thelateperseus/OffroadBalancingRobot/README.md

Offroad Balancing Robot Project
===============================

An Arduino-based, two-wheeled balancing robot which can (hopefully) go offroad.

Components:
* Arduino Nano 33 IoT
* 2x Pololu VNH5019  motor driver
* 2x Pololu 30:1 Metal Gearmotor 37Dx68L mm 12V with 64 CPR Encoder
* 2x Dago Wild Thumper Wheels
* MPU-6050 6 DoF sensor (testing only)

Control Algorithm
-----------------

TODO
