thelateperseus/OffroadBalancingRobot/ball-tracking-tensorflow/requirements_pypi.txt

argparse
imutils==0.5.4
numpy~=1.21.0
opencv-python~=4.5.3.56
picamera==1.13
pyserial==3.5
simple_pid~=1.0.1
smbus~=1.1
