thelateperseus/OffroadBalancingRobot/SpeedFilterTest/FirstOrder4Hz.png

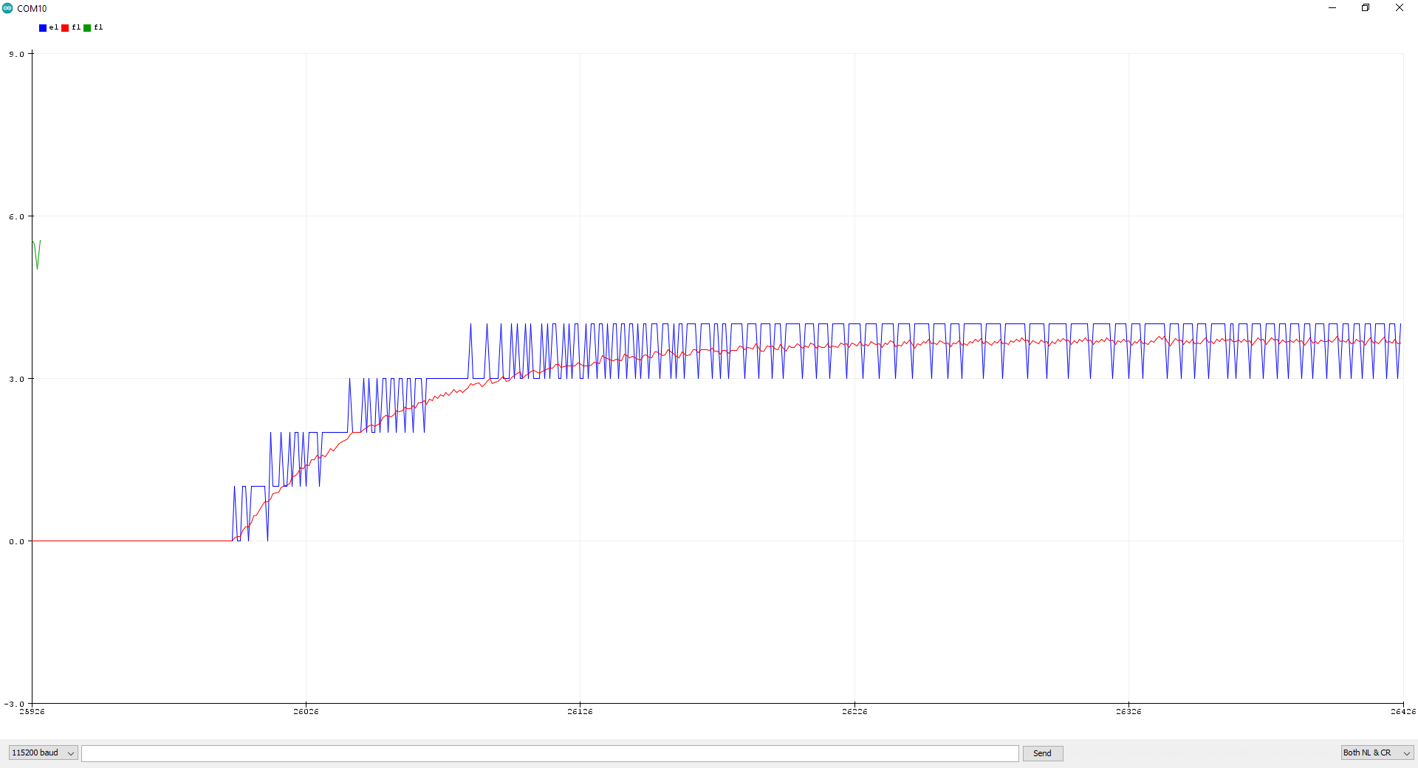
SpeedFilterTest/FirstOrder4Hz.png
