thelateperseus/OffroadBalancingRobot/SpeedFilterTest/FourthOrder4Hz.png

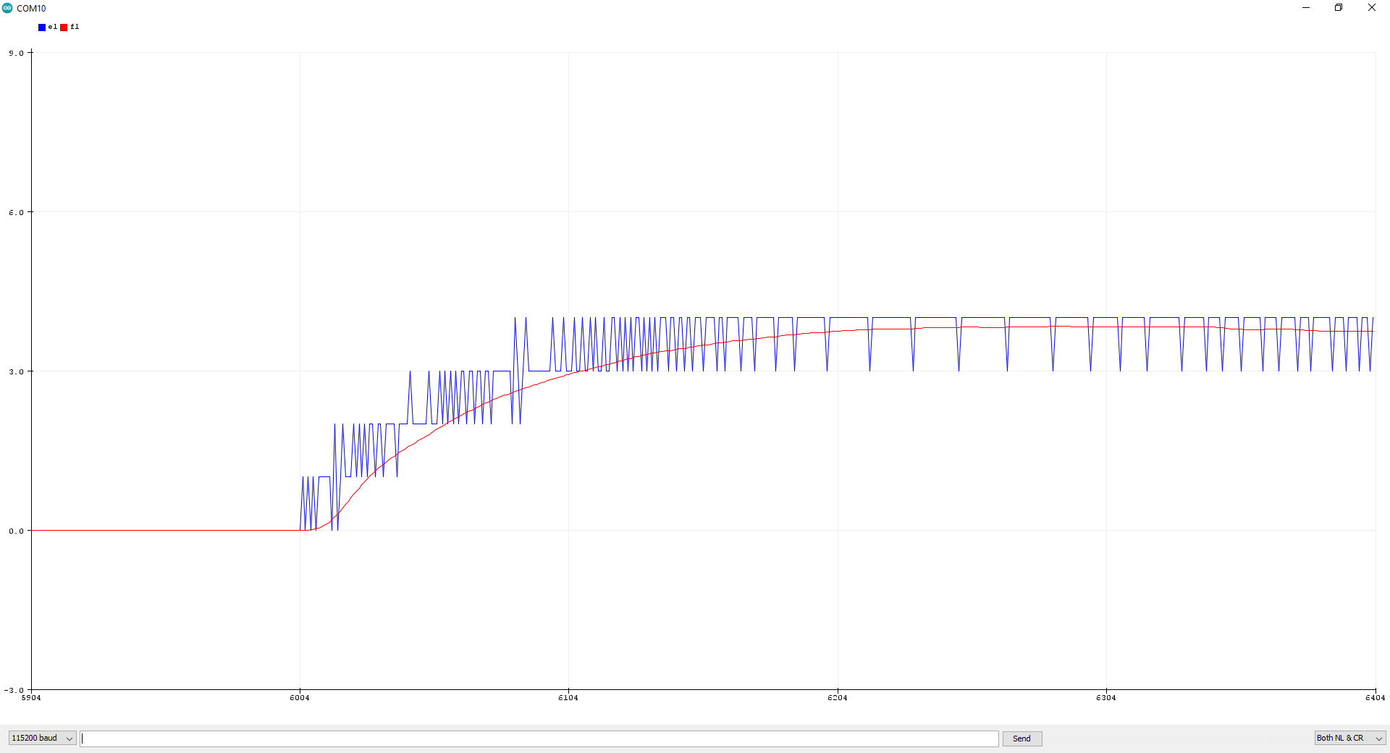
SpeedFilterTest/FourthOrder4Hz.png
