thelateperseus/OffroadBalancingRobot/SpeedFilterTest/SecondOrder1Hz.png

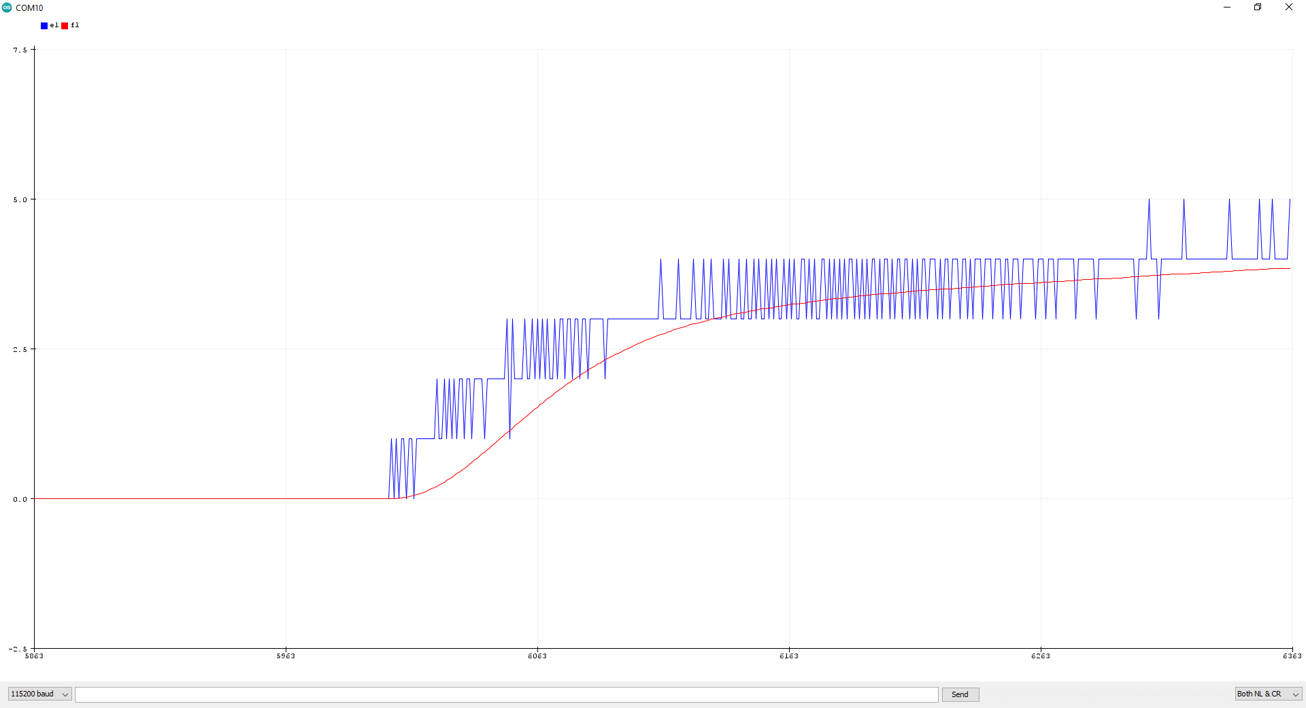
SpeedFilterTest/SecondOrder1Hz.png
