thelateperseus/OffroadBalancingRobot/SpeedFilterTest/SecondOrder4Hz.png

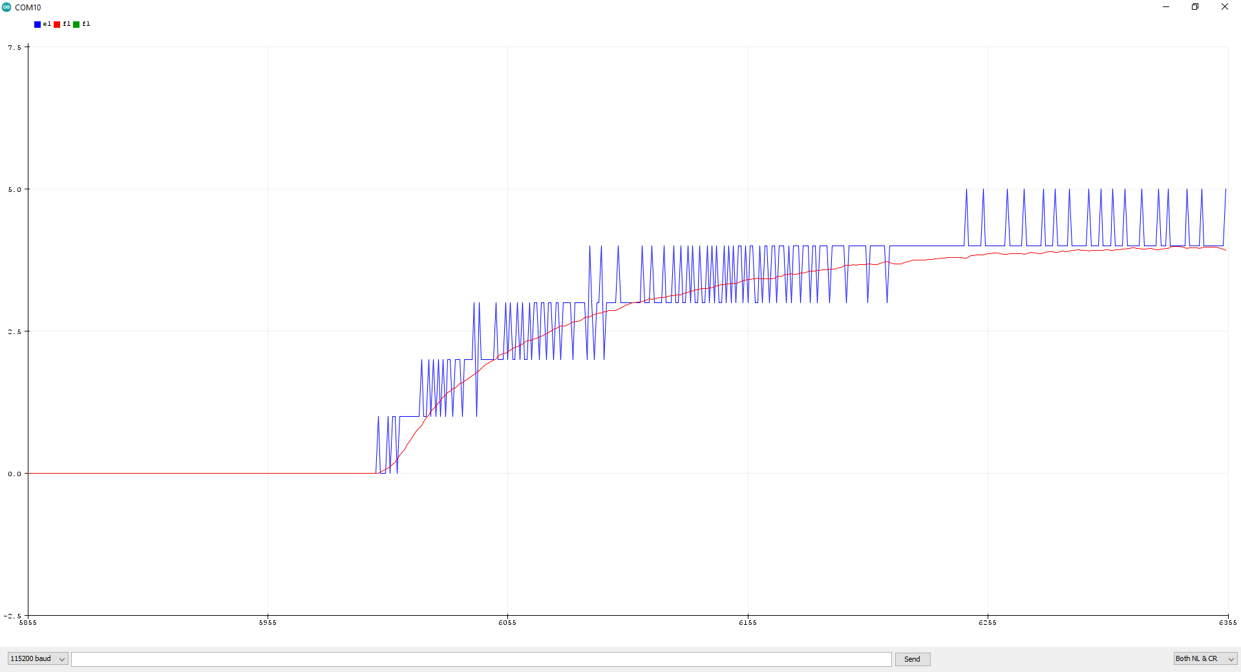
SpeedFilterTest/SecondOrder4Hz.png
