thelateperseus/OffroadBalancingRobot/SpeedFilterTest/SecondOrder10Hz.png

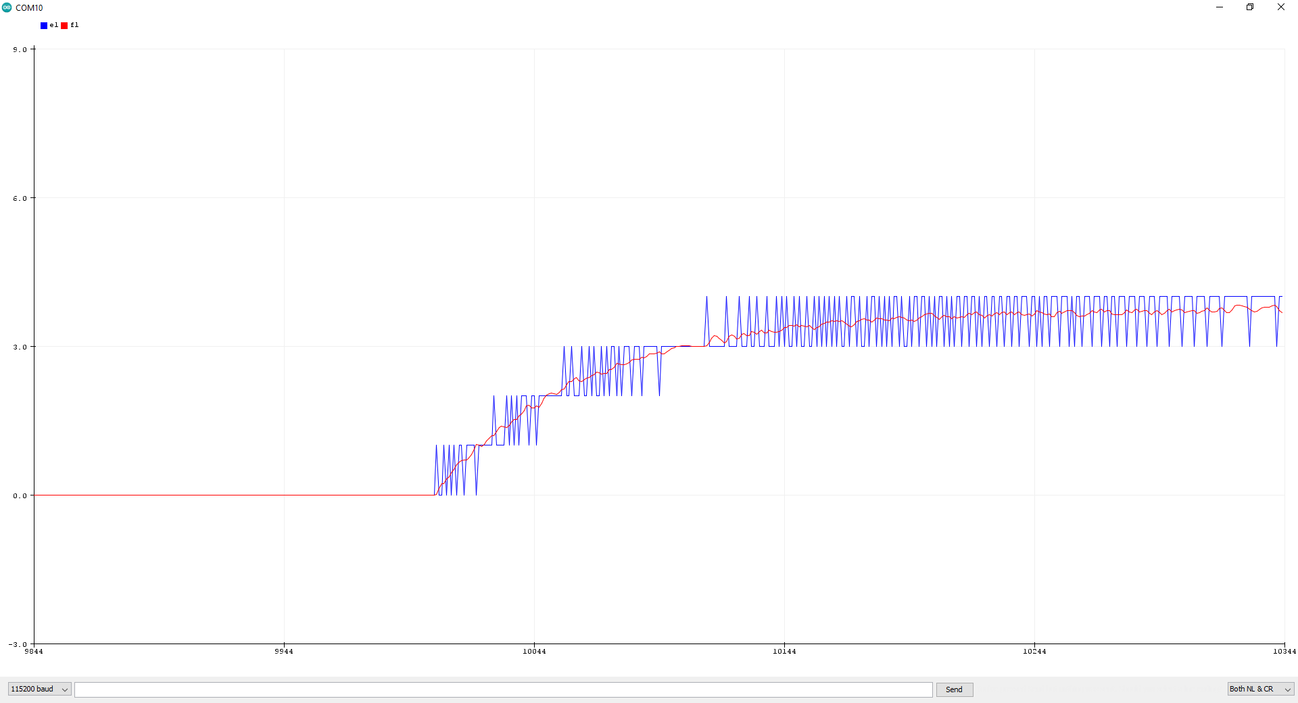
SpeedFilterTest/SecondOrder10Hz.png
