thelateperseus/OffroadBalancingRobot/pololu-machined-aluminum-bracket-for-37d-mm-metal-gearmotors.step

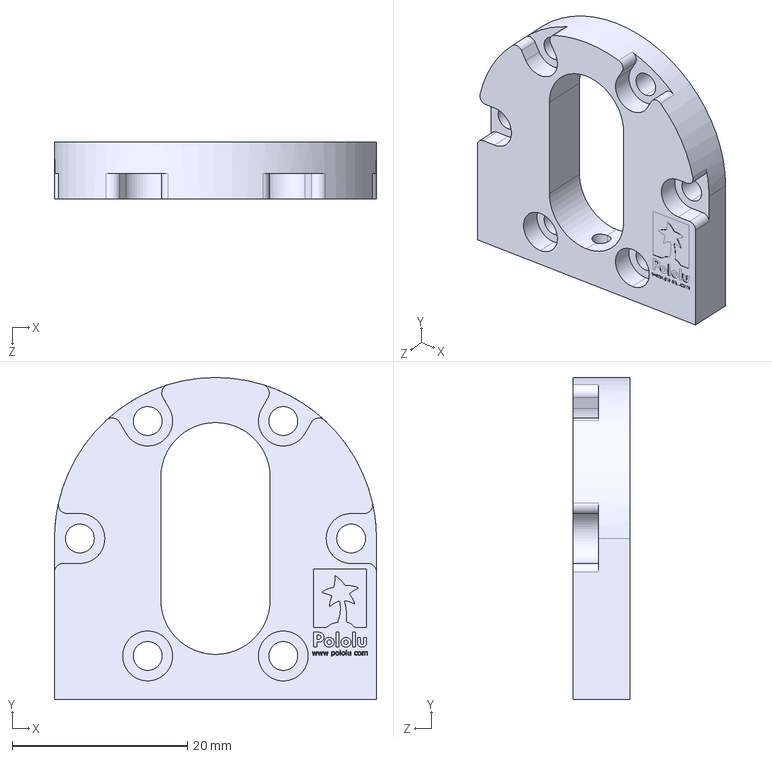
[picture p6: CAD file, 2021-11-14]
pololu-machined-aluminum-bracket-for-37d-mm-metal-gearmotors.step
36.8 x 36.8 x 6.50 mm
