thelateperseus/OffroadBalancingRobot/MotorEncoderTest/Results.txt

16:51:57.156 -> PWM Value: 0
16:51:57.156 -> 0
16:51:58.144 -> 0
16:51:59.163 -> 0
16:52:00.159 -> 0
16:52:01.175 -> 0
16:52:02.210 -> 0
16:52:03.202 -> 0
16:52:04.221 -> 0
16:52:05.212 -> 0
16:52:06.232 -> 0
16:52:14.610 -> PWM Value: 8
16:52:14.610 -> 0
16:52:15.632 -> 0
16:52:16.624 -> 0
16:52:17.646 -> 0
16:52:18.630 -> 0
16:52:19.644 -> 0
16:52:20.670 -> 0
16:52:21.685 -> 0
16:52:22.671 -> 0
16:52:23.691 -> 0
16:52:24.711 -> 0
16:52:32.998 -> PWM Value: 16
16:52:32.998 -> 0
16:52:33.981 -> 208
16:52:35.002 -> 276
16:52:36.028 -> 280
16:52:37.014 -> 280
16:52:38.031 -> 281
16:52:39.054 -> 282
16:52:40.075 -> 282
16:52:41.064 -> 282
16:52:42.080 -> 282
16:52:43.094 -> 282
16:52:44.117 -> 282
16:52:52.091 -> PWM Value: 12
16:52:52.091 -> 0
16:52:53.110 -> 95
16:52:54.136 -> 120
16:52:55.120 -> 122
16:52:56.141 -> 121
16:52:57.158 -> 122
16:52:58.175 -> 122
16:52:59.158 -> 121
16:53:00.176 -> 120
16:53:01.191 -> 121
16:53:02.210 -> 121
16:53:03.200 -> 123
16:53:04.219 -> 120
16:53:05.235 -> 121
16:53:06.257 -> 122
16:53:07.240 -> 121
16:53:15.067 -> PWM Value: 24
16:53:15.067 -> 0
16:53:16.049 -> 453
16:53:17.067 -> 615
16:53:18.095 -> 628
16:53:19.112 -> 630
16:53:20.104 -> 633
16:53:21.127 -> 635
16:53:22.151 -> 635
16:53:23.137 -> 635
16:53:24.156 -> 636
16:53:25.175 -> 637
16:53:26.196 -> 639
16:53:27.186 -> 640
16:53:28.210 -> 641
16:53:36.447 -> PWM Value: 32
16:53:36.447 -> 0
16:53:37.457 -> 695
16:53:38.477 -> 953
16:53:39.505 -> 979
16:53:40.497 -> 982
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
16:57:32.966 -> 117
16:57:33.986 -> 115
16:57:34.970 -> 13

At PWM value 12, the shaft appeared to spin once every 4 seconds. 
115 counts per second / 16 counts per revolution = 7.2 revolutions per second
7.2 revolutions per second / 30 (gear ratio) = 0.25 shaft revolutions per second
