thelateperseus/OffroadBalancingRobot/MotorEncoderTest/DualResults_LevelShifter.txt

18:38:17.078 -> 16,0,0
18:38:18.104 -> 16,646,648
18:38:19.082 -> 16,838,830
18:38:20.107 -> 16,744,835
18:38:21.087 -> 16,922,864
18:38:22.064 -> 16,744,822
18:38:23.090 -> 16,906,876
18:38:24.066 -> 16,775,820
18:38:25.091 -> 16,825,867
18:38:26.068 -> 16,857,828
18:38:27.092 -> 20,750,852
18:38:28.067 -> 20,1300,1250
18:38:29.091 -> 20,1446,1433
18:38:30.066 -> 20,1414,1437
18:38:31.090 -> 20,1416,1436
18:38:32.065 -> 20,1453,1451
18:38:33.090 -> 20,1425,1458
18:38:34.065 -> 20,1389,1448
18:38:35.090 -> 20,1398,1444
18:38:36.064 -> 20,1442,1456
18:38:37.087 -> 24,1404,1468
18:38:38.108 -> 24,1796,1847
18:38:39.086 -> 24,1994,2049
18:38:40.109 -> 24,1992,2058
18:38:41.087 -> 24,2006,2061
18:38:42.111 -> 24,1989,2064
18:38:43.086 -> 24,1948,2068
18:38:44.110 -> 24,1941,2075
18:38:45.087 -> 24,1936,2074
18:38:46.108 -> 24,1946,2070
18:38:47.085 -> 32,1944,2069
18:38:48.109 -> 32,2671,2790
18:38:49.089 -> 32,3068,3184
18:38:50.067 -> 32,3062,3209
18:38:51.091 -> 32,3068,3224
18:38:52.067 -> 32,3049,3210
18:38:53.091 -> 32,3057,3204
18:38:54.068 -> 32,3053,3213
18:38:55.092 -> 32,3035,3218
18:38:56.070 -> 32,3037,3208
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

Forwards
--------

18:41:55.752 -> 8,0,0
18:41:56.729 -> 8,7,0
18:41:57.754 -> 8,0,0
18:41:58.729 -> 8,0,0
18:41:59.754 -> 8,0,0
18:42:00.731 -> 8,0,0
18:42:01.753 -> 8,0,0
18:42:02.732 -> 8,0,0
18:42:03.752 -> 8,0,0
18:42:04.731 -> 8,0,0
18:42:05.753 -> 12,0,0
18:42:06.731 -> 12,1,263
18:42:07.753 -> 12,0,366
18:42:08.732 -> 12,0,311
18:42:09.755 -> 12,0,352
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
19:11:25.206 -> 20,-1277,-1314
19:11:26.230 -> 20,-1439,-1482
19:11:27.201 -> 20,-1442,-1485
19:11:28.222 -> 20,-1450,-1484
19:11:29.198 -> 20,-1452,-1495
19:11:30.219 -> 20,-1437,-1500
19:11:31.191 -> 20,-1439,-1510
19:11:32.211 -> 20,-1440,-1515
19:11:33.188 -> 20,-1449,-1518
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
