thelateperseus/OffroadBalancingRobot/Offroad Balancing Robot Drill Template v1.pdf

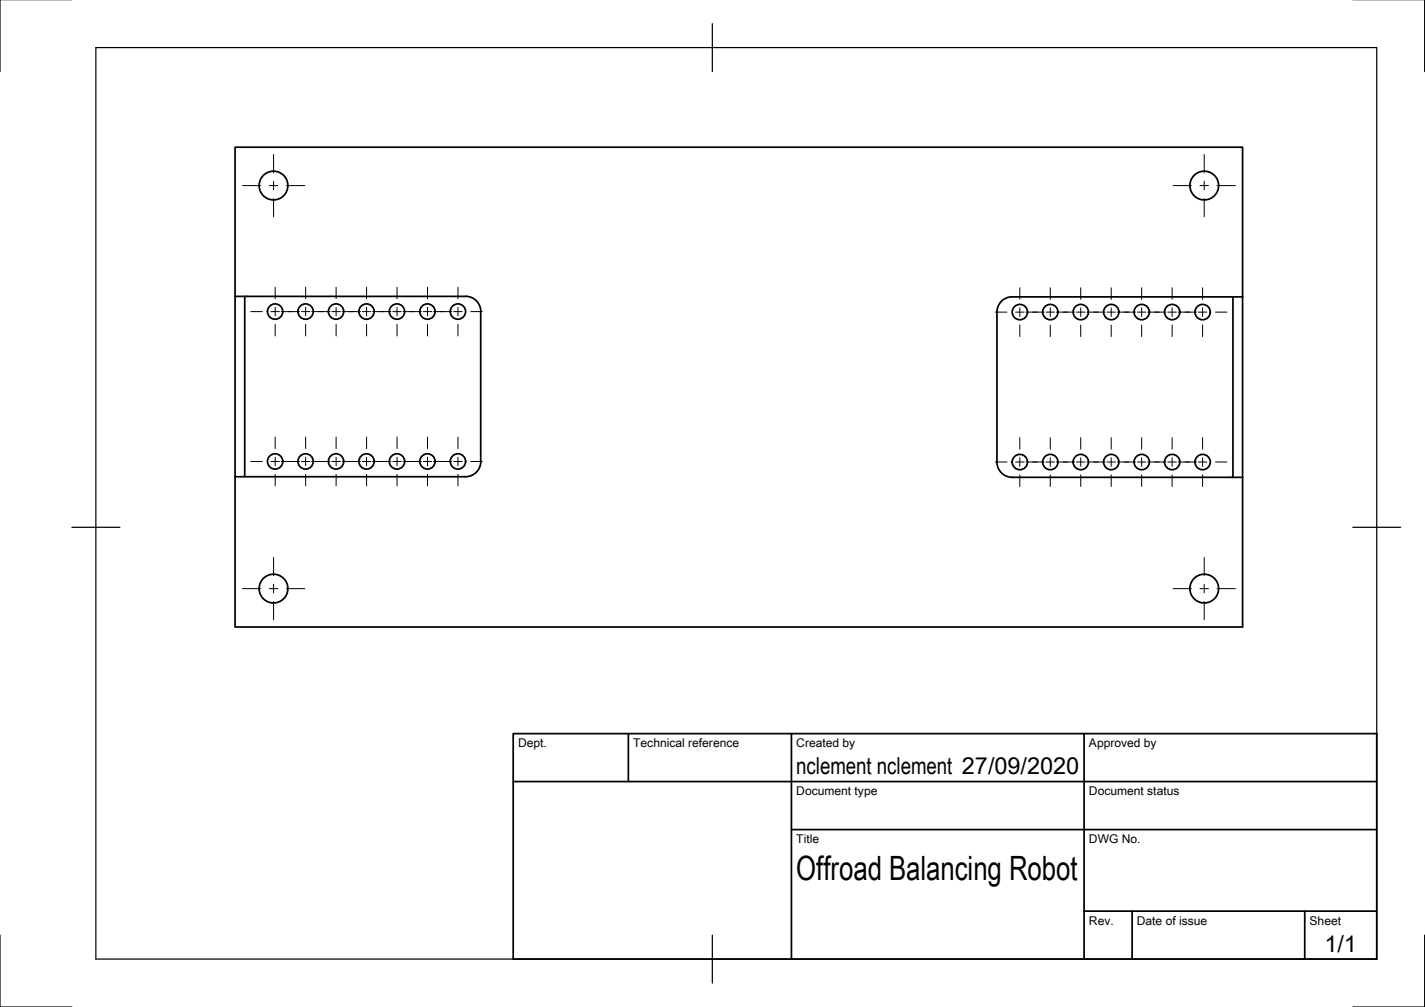
[picture p7: page 1]

Dept. | Technical reference | Created by nclement nclement 27/09/2020 | Approved by

Document type | Document status

Title Offroad Balancing Robot | DWG No.

Rev. | Date of issue | Sheet 1/1
