thelateperseus/OffroadBalancingRobot/ball-tracking/ball-tracking.py

# import the necessary packages
from collections import deque
from imutils.video import VideoStream
from pantilthat import PanTiltHat
from simple_pid import PID
import numpy as np
import argparse
import cv2
import imutils
import time

pth = PanTiltHat()
pth.pan(0)
pth.tilt(20)

pidPan = PID(0.1,
             0.5,
             0.0,
             setpoint=160,
             sample_time=None,
             output_limits=(-75, 75),
             auto_mode=False)
pidTilt = PID(0.075,
              0.375,
              0.0,
              setpoint=120,
              sample_time=None,
              output_limits=(-75, 30),
              auto_mode=False)

# construct the argument parse and parse the arguments
ap = argparse.ArgumentParser()
ap.add_argument("-v", "--video", help="path to the (optional) video file")
ap.add_argument("-b", "--buffer", type=int, default=64, help="max buffer size")
args = vars(ap.parse_args())

# define the lower and upper boundaries of the "pink"
# ball in the HSV color space, then initialize the
# list of tracked points
#pinkLower = (117,93,0)
#pinkUpper = (196,209,134)
pinkLower = (117, 85, 0)
pinkUpper = (175, 209, 255)
pts = deque(maxlen=args["buffer"])

# if a video path was not supplied, grab the reference
# to the webcam
if not args.get("video", False):
    vs = VideoStream(src=0,
                     usePiCamera=True,
                     resolution=(320, 240),
                     framerate=20).start()

# otherwise, grab a reference to the video file
else:
    vs = cv2.VideoCapture(args["video"])

# allow the camera or video file to warm up
time.sleep(2.0)

# keep looping
while True:
    startTime = time.time()

    # grab the current frame
    frame = vs.read()

    # handle the frame from VideoCapture or VideoStream
    frame = frame[1] if args.get("video", False) else frame

    # if we are viewing a video and we did not grab a frame,
    # then we have reached the end of the video
    if frame is None:
        break

    # resize the frame, blur it, and convert it to the HSV
    #
#  color space
#frame = imutils.resize(frame, width=600)
    blurred = cv2.GaussianBlur(frame, (11, 11), 0)
    hsv = cv2.cvtColor(blurred, cv2.COLOR_BGR2HSV)

    # construct a mask for the color "pink", then perform
    # a series of dilations and erosions to remove any small
    # blobs left in the mask
    mask = cv2.inRange(hsv, pinkLower, pinkUpper)
    mask = cv2.erode(mask, None, iterations=2)
    mask = cv2.dilate(mask, None, iterations=2)

    # find contours in the mask and initialize the current
    # (x, y) center of the ball
    cnts = cv2.findContours(mask.copy(), cv2.RETR_EXTERNAL,
                            cv2.CHAIN_APPROX_SIMPLE)
    cnts = imutils.grab_contours(cnts)
    center = None
    radius = None

    # only proceed if at least one contour was found
    if len(cnts) > 0:
        # find the largest contour in the mask, then use
        # it to compute the minimum enclosing circle and
        # centroid
        c = max(cnts, key=cv2.contourArea)
        ((x, y), radius) = cv2.minEnclosingCircle(c)
        M = cv2.moments(c)
        centre = (int(M["m10"] / M["m00"]), int(M["m01"] / M["m00"]))
        print(
            f'time: {time.time() - startTime:.3f}, centre: {centre}, radius: {radius:.2f}'
        )

        # only proceed if the radius meets a minimum size
        if radius > 5:
            # draw the circle and centroid on the frame,
            # then update the list of tracked points
            cv2.circle(frame, (int(x), int(y)), int(radius), (0, 255, 255), 2)
            cv2.circle(frame, centre, 5, (0, 0, 255), -1)

        else:
            radius = None

    if radius == None:
        # Reset PID controllers if ball not found
        pidPan.set_auto_mode(False)
        pidTilt.set_auto_mode(False)

    else:
        pidPan.set_auto_mode(True, last_output=0)
        pidTilt.set_auto_mode(True, last_output=20)
        panAngle = pidPan(centre[0])
        tiltAngle = pidTilt(240 - centre[1])
        #print(f'panAngle: {panAngle}, tiltAngle: {tiltAngle}')
        pth.pan(panAngle)
        pth.tilt(tiltAngle)

    # TODO stream to Flask server
    # show the frame to our screen
    cv2.imshow("Frame", frame)
    key = cv2.waitKey(1) & 0xFF

    # if the 'q' key is pressed, stop the loop
    if key == ord("q"):
        break

# if we are not using a video file, stop the camera video stream
if not args.get("video", False):
    vs.stop()

# otherwise, release the camera
else:
    vs.release()

# close all windows
cv2.destroyAllWindows()

# disable the servos
pth.shutdown()
