thelateperseus/OffroadBalancingRobot/(commit log)

2020-08-20 Calculate pitch angle from MPU-6050
2020-08-21 Functions to read accelerometer and gyro
2020-08-24 Switched to built-in IMU
2020-08-24 Show internal and external IMU data
2020-09-11 Test programs for motor driver and interrupts.
2020-09-12 First test of encoder using only one rising pulse
2020-09-19 Loop through all test PWM values
    Also print the PWM, the measurement interval and the encoder pulse count for easy import into Excel.
2020-10-03 Read both outputs of Encoder
    This gives 64 pulses per revolution for increased accuracy.
    Also included the drilling template for mounting the motor brackets to the base plate.
2020-10-03 Moved encoder logic to a separate class
2020-11-07 Bluetooth data plotting and command parsing
    Test sketch to collect faster data from the LSM6DS3 IMU (208Hz) and broadcast this over bluetooth via an attached HC-05. This data can be plotted in the Arduino IDE once the COM port is changed to the Bluetooth one. This will be useful to see how effective various PID controller settings are.
    Another test sketch to parse commands received via the Bluetooth serial interface. This will be useful to dynamically set PID constants without having to upload new code to the Arduino.
    Another test sketch showing how to receive input from the RC transmitter, which will eventually be used to control the speed and direction of the robot.
2021-05-05 Changed pin assignments and added second motor
2021-06-04 Sketched out code for PID control
    Basic proportional controller using internal IMU sensor. Also reassigned
    some Arduino pins to free up builtin LED pin.
2021-06-05 First attempt at PID tuning
    Started with James Bruton's ration of kp:ki:kd of 10:100:1 and had some
    success. The robot vibrates quite a lot, presumably due to the gearbox
    backlash when changing directions. Hopefully further tuning will help
    resolve this.
    [OffroadBalancingControl.ino, SerialCommand.cpp, SerialCommand.h]
2021-06-06 Improved balancing OffroadBalancingControl
    Increased KI and KD for better stability, but the robot still oscillates
    a bit. Also implemented deadband for speed to try to stop it drifting to
    one side. The deadband keeps the speed at zero below a threshold. I
    think this is responsible for the oscillation because the robot falls
    a bit while the motors are stationary.
    [BluetoothIMUData.ino, OffroadBalancingControl.ino]
2021-06-07 Improved balance control
    Changed deadband handling logic to scale the speed so that it is always
    higher than the configured deadband. Retuned the PID constants
    accordingly. The robot can balance, but vibrates when close to
    stationary. This is most likely due to backlash in the motor gearbox.
    Maybe further tuning of the PID constants can reduce this.
    [BluetoothIMUData.ino, MotorEncoderTest.ino, OffroadBalancingControl.ino]
2021-06-14 Adjusted PID constants and encoder speed filtering
    Tuned the PID constants to be less aggressive, but the result was pretty
    much the same. The robot still vibrates due to backlash when stationary.
    Wrote a test program to test the filtering of the encoder signal. The
    delta value from the encoder is read at 250Hz and run through a 10Hz low
    pass filter. The result is much less noisy than the raw integer-based
    encoder value.
    [Encoder.cpp, Encoder.h, EncoderSpeedTest.ino, OffroadBalancingControl.ino]
2021-06-19 Added direction correction PID using encoders
    Measure the total encoder counts for each wheel, take the difference,
    then feed this into a PID controller to correct for differences between
    the motor deadbands.
    [Encoder.cpp, Encoder.h, OffroadBalancingControl.ino]
2021-06-19 Added speed control using RC transmitter
    Changed the balance auto-correction from a simple accumulator to a PID
    controller. Used RC receiver to alter the speed setpoint so the robot
    can move forwards or backwards.
    The speed PID controller needs a lot more tuning as the movement is
    very jerky, as was the case in the Barbie Segway. But it's a start at
    least.
    [OffroadBalancingControl.ino, RCTest.ino]
2021-06-20 Fixed reset code, added steering
    I noticed the robot would charge off after reset (i.e. running, me
    tipping over past 45 degrees, then standing it up again). I changed the
    reset function to zero out all the variables used by the PID
    controllers, which fixed the problem.
    I also added steering via the RC transmitter. The direction PID
    controller turns off when there is a steering signal received. The robot
    balances quite well while turning, but the width of the tyres seems to
    mean that at least one tyre needs to slip on the floor for both wheels
    to rotate while turning. Mostly, only one wheel rotates, but the result
    is still good.
    Driving still takes a long time to accelerate. I think that a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
    [OffroadBalancingControl.ino]
2021-06-20 Changed speed SpeedFilterTest
    Changed the speed filter from 10Hz cutoff to 4Hz cutoff and saw a
    reduction in the noise level. This will hopefully allow KP and KI to be
    increased on the speed PID controller.
    Also made the steering linear depending on how far the RC steering wheel
    is turned. The steering still feels a little sluggish, so maybe I'll
    increase the multiplier.
    [Encoder.cpp, Encoder.h, OffroadBalancingControl.ino, RCTest.ino, SpeedFilterTest.ino]
2021-07-04 Tuned speed PID controller for responsive driving
    The robot starts moving straight away now rather than having to wait
    several seconds. The speed fluctuates quite a lot, and there is
    noticable oscillation while the robot drives.
    The robot can go over small bumps and from hard floor to carpet. The
    driving motion is smoother on carpet, at the expense of stability when
    stationary. This hints that there is a tradeoff between the performance
    of the balance PID controller and the speed PID controller. Reducing the
    PID constants for the balance controller and increasing them for the
    speed controller may be the path to better driving performance.
    [driving_data.csv, driving_data.xlsx]
2021-07-16 Tuned speed PID, increased max steering and speed
    Reducing both kp and ki in the speed PID controller resulted in smoother
    driving.
    Increasing the deadband did not improve the performance of the robot at
    all. Restesting on carpet showed similar speed harmonics as on a smooth
    surface. Reducing kp and ki in the angle PID controller also did not
    improve driving performance, and just increased the harmonics in the
    speed.
    [driving_data2.csv]
2021-07-16 Reduced both ki values
    I guessed that the speed harmonics were due to too much integral action
    from the controllers. For the angle controller, I decreased ki by 25%
    and increased kp by 33%. This had minimal impact on the stability of the
    robot when standing, but made the driving speed much smoother.
    I also increased kp and reduced ki for the speed controller. The
    acceleration is slower, but the driving motion is smoother.
    [OffroadBalancingControl.ino]
2021-07-18 Further tuning of angle PID controller
    Increased KD in the angle PID controller to try to minimise the angle
    overshoot when driving. This made a small difference to the smoothness
    of the driving - see Data3, Data4 and Data7 worksheets in the
    spreadsheet.
    The speed controller does not seem to result in the robot reaching the
    desired speed very often. Increasing KI in the speed controller should
    help with this. However, I'm wondering whether the relationship between
    angle and driving speed will be non-linear, so I want to try increasing
    the maximum speed from 6 to 10 before tuning the speed controller
    further.
    [driving_data3.csv, driving_data4.csv, driving_data5.csv, driving_data6.csv, driving_data7.csv]
2021-07-22 Added low pass filter to accelerometer data
    The pitch angle was noisy and I figured this might be due to inadequate
    filtering of the accelerometer data. The LSM6DS3 apparently has a
    built-in low pass filter, but I couldn't get it to enable so I coded one
    myself. The result is a cleaner signal fed into the angle controller,
    which will hopefully allow KD to be increased.
    I also experimented with changing alpha in the complementary angle
    filter from 0.996 to 0.96. The goal was to reduce the time taken to
    correct gyro drift. However, the robot did not balance well (see
    imu_data.xlsx). My theory is that the drift is reduced, and so the speed
    controller changes the angle set point too quickly and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
    [angle_filter_data.xlsx, driving_data8.csv, driving_data9.csv, imu_data.xlsx]
2021-07-23 Tweaked speed PID controller
    I tried increasing KD on the angle controller from 2 to 3, but this
    resulted in more shaking when upright.
    I then tried changing the speed controller KP from 0.3 to 0.25 and KI
    from 0.15 to 0.18. This had minimal effect on the smoothness of the
    driving, but is maybe _slightly_ better.
    I also changed the startup code to again use the accelerometer data to
    detect when the robot is upright to start balancing. The drift in the
    complementary filter is too high to rely on the filtered value.
    [driving_data10.csv, driving_data11.csv]
2021-07-24 Increased top speed to 15
    We want the robot to go fast because it's cooler. Increased the top
    speed to 15 encoder counts per loop. The loop period is 4ms, there are
    64 encoder counts per motor revolution, and the motor gearbox ratio is
    30:1, so this translates to ~120rpm at the wheels (which is 1/3
    of the max unloaded speed of the motors).
    The steering correction still doesn't seem to work when driving
    straight. I suspect this is because of spikes in the RC signal which
    cause the sterring error to be reset (since it looks like the driver is
    attempting to steer manually). We need some kind of notch filter to
    reject any values which look like noise.
    [OffroadBalancingControl.ino]
2021-08-05 Improve remote control spike filtering
    I noticed a couple of cases where the RC signal changed rapidly and the
    robot was left perpetually turning in a circle. To avoid this, I changed
    the spike detection to allow for only 2 spikes (where the old and new
    reading differ by more than 400us) before using the signal as is. This
    should eliminate the noise from the signal without the signal getting
    locked on an incorrect value.
    [OffroadBalancingControl.ino, RCTest.ino]
2021-08-21 Switched RC channel pins for PCB
    I must have made a mistake in the design about which RC channel connects
    to which Arduino pin, so I switched them around in the code to
    compensate.
    [OffroadBalancingControl.ino]
2021-11-14 Object detection using TensorFlow
    [pololu-machined-aluminum-bracket-for-37d-mm-metal-gearmotors.step]
2021-12-16 Added RCChannel library
    Added RCChannel library to Arduino code to modularise things better. The
    main OffroadBalancingControl.ino file should just join the various
    components together, otherwise it will grow too large.
    [OffroadBalancingControl.ino, RCChannel.cpp, RCChannel.h, RCTest.ino]
2021-12-17 Allow steering from Raspberry Pi ball tracking
    Added code to the Arduino OffroadBalancingRobot.ino to accept a
    space-separated list of floating-point numbers. The first number is the
    desired speed (in encoder counts per loop, min -5, max 5), and the second is
    the speed (as a PWM value, min -40, max 40). The speed value is ignored for
    now. Both the speed and steering serial commands are overridden by the RC
    transmitter.
    Added a new PID controller to ball-tracking.py that tries to keep the pan
    angle of the camera at zero (i.e. the ball is right in front of the robot).
    This currently uses a proportional component only to try to keep things
    simple. The output of the PID controller is written to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
2021-12-17 Allow speed control from Rasbperry Pi
    The Arduino program now parses the speed command received over the serial
    channel from the Raspberry Pi. The Pi uses another PID controller based on
    the width of the detected ball to compute the speed.
2021-12-17 Changed speed controller to be less agressive
    The speed controller KP setting caused the robot to overshoot the
    distance setpoint and oscillate, verging on becoming unstable. I
    reduced the KP setting to avoid this, and also changed the code so
    that the speed PID controller only runs when the robot is facing
    the ball.
    [ball-tracking.py]
2021-12-27 Use VideoCapture and perf_counter
    Camera feed would stop about 20 seconds after the program started, i.e.
    when the clock changed due to time sync. It's unclear why the imutils
    VideoStream has this problem, but replacing it with a similar class that
    uses OpenCV's VideoCapture to read the images from the camera solves the
    issue. Also, used time.perf_counter instead of time.time so that the FPS
    count is independent of the system clock.
    [ball-tracking.py]
